Gioiee3/Extensometer-LoRa/README.md

# Extensometer with LoRa E32-400M30S
geological crack monitoring and landslide warning device using LoRa with esp32 and stm32
