Gioiee3/Extensometer-LoRa/Hardware/Extensometer/Project Outputs for Extensometer/Extensometer.xls

Comment | Description | Designator | Footprint | LibRef | Quantity
S4 | Dán | 1, 2, 4 | DIO-214AC(SMA) | Diode S4 | 3
47 uH | Inductor | 3, 0630 | inductor-7mm | Inductor | 2
Test Point | CONNECT 1 | 5V_off, 7V6, Solar, TP5 | TP_SMD | TP | 4
JP2 | WR-PHD 2.54 mm Angled Socket Header | BAT1S, BAT 1S, Light | JP2-C1T | JP2 | 3
100nF | Capacitor | C1, C3, C4, C6, C8, C10, C11, C12, C13, C14, C16, C18, C19, C21, C23, C24, C26, C28 | CAP_0805 | CapSMD | 18
10uF | Capacitor | C2, C5, C20, C22, C25, C29, C30 | CAP_0805 | CapSMD | 7
100uf/50V | Polarized Capacitor (Axial) | C7, C15 | CAP-ALU-SMD-8.3 | Cap Pol | 2
220uF/35V | Polarized Capacitor (Axial) | C9, C17 | CAP-ALU-SMD-8.3 | Cap Pol | 2
100nF | Capacitor | C27 | CAP_0402 | CapSMD | 1
SS54 | SS34 | D1, D2 | DIO-214AC(SMA) | Diode Zener | 2
SW | Switch button 2 pin | D35, VN, VP | SW2 | SW2 | 3
MAX485 | RS232 - RS485 (Same sn75176) | IC1 | SO-8 | MAX485 | 1
Connector 4x2 | Connector 4x2 | J1 | JP4x2 | JP4x2 | 1
Connector 3x2 | Connector 3x2 | J2 | JP3x2 | JP3x2 | 1
BAT | Jac DC input | JDC1 | DC-IN | DCIN | 1
BATTERY | Jac DC input | JDC2 | DC-IN | DCIN | 1
Adapter | Jac DC input | JDC3 | DC-IN | DCIN | 1
JP4 | WR-PHD 2.54 mm Angled Socket Header | LCD, SIM | JP4-C1T | JP4 | 2
LED | LED Single colour Green and Red | LED, LED2, LED3 | LED-0805-Blue | LED | 3
JP2 | WR-PHD 2.54 mm Angled Socket Header | MPPT | KF-128_2P_3.81 | JP2 | 2
2SC1815 | NPN 600mW, ECB | Q1, Q2, Q5, Q7 | SOT23D | C1815 | 4
AO3401 | 30V 5.8A P-Channel MOSFET | Q3, Q4, Q6, Q8 | SOT23A | MOSFET_P | 4
RU20P7C | 30V 5.8A P-Channel MOSFET | Q9, Q10 | SOT23A | MOSFET_P | 2
100k | Resistor SMD, Resistor | R1, R2, R5, R6, R19, R22, R32, R35, R36 | RES-SMD-0805 | Resistor - SMD | 9
1k | Resistor SMD, Resistor | R3, R4, R17, R20, R21, R34, R37 | RES-SMD-0805 | Resistor - SMD | 7
10k | Resistor | R7, R8, R9, R28, R29, R33 | RES-SMD-0805 | Resistor - SMD | 6
680R | Resistor | R10, R12 | RES-SMD-0805 | Resistor - SMD | 2
120 | Resistor | R11 | RES-SMD-0805 | Resistor - SMD | 1
10k | Resistor SMD | R13, R14, R23, R24, R25 | RES_SMD_0805 | Resistor - SMD | 5
39k | Resistor | R15, R27 | RES-SMD-0805 | Resistor - SMD | 2
0R | Resistor | R16, R26 | RES-SMD-0805 | Resistor - SMD | 2
11k | Resistor | R18 | RES-SMD-0805 | Resistor - SMD | 1
14k | Resistor | R30 | RES-SMD-0805 | Resistor - SMD | 1
3k9 | Resistor | R31 | RES-SMD-0805 | Resistor - SMD | 1
JP5 | WR-PHD 2.54 mm Angled Socket Header | Sensor | KF5-5 | JP5x1 | 1
A5 | Switch button 2 pin | SW1 | SW2 | SW2 | 1
A7 | Switch button 2 pin | SW2 | SW2 | SW2 | 1
SK12D07VG4 | Switch Slide ON ON SPDT Side Slide 0.3A 30VDC PC Pins Bracket Mount/Through Hole Bulk | Switch1 | SS12D01 | SK12D07VG4 | 1
SK12D07VG4 | Switch Slide ON ON SPDT Side Slide 0.3A 30VDC PC Pins Bracket Mount/Through Hole Bulk | Switch2 | SK12D07VG4 | SK12D07VG4 | 1
E32-400M30S |  | SX1, SX1278 | E32-400M30S | E32-400M30S | 2
JP8 PIN | JP8 PIN | TFT | JP8 | JP8 | 1
ESP32-DEVKIT-V1 | Dual core, Wi-Fi: 2.4 GHz up to 150 Mbits/s,BLE (Bluetooth Low Energy) and legacy Bluetooth, 32 bits, Up to 240 MHz | U1 | MODULE_ESP32_DEVKIT_V1 | ESP32-DEVKIT-V1 | 1
STM32 BluePill | STM32F103C8T6 breakout board | U2 | STM32 Bluepill | STM32 BluePill | 1
LM2976 |  | U3, U4 | TO-263 | LM2596 | 2
Ra-02 LoRa | LoRa Module Ra-02 | U5, U6 | Ra-02 | Ra-02 LoRa | 2
