Gioiee3/Extensometer-LoRa/Hardware/Extensometer/Project Outputs for Extensometer/List.xlsx

Comment | Description | Designator | Footprint | LibRef | Quantity
S4 | Dán | 1, 2, 4 | DIO-214AC(SMA) | Diode S4 | 3 | x
47 uH | Inductor | 3, 0630 | inductor-7mm | Inductor | 2 | x | CXT.VN – Từ ý tưởng đến sản phẩm - Cuộn cảm 47uH 0630 7x7x3mm (https://linhkien.cxt.vn/10533-cuon-cam-0630-cac-gia-tri.html)
10uF | Capacitor | C2, C5, C20, C22, C25, C29, C30 | CAP_0805 | CapSMD | 7 | x
100uf/50V | Polarized Capacitor (Axial) | C7, C15 | CAP-ALU-SMD-8.3 | Cap Pol | 2 | x | https://linhkien.cxt.vn/3033-tu-nhom-100uf-50v-8x105.html
220uF/35V | Polarized Capacitor (Axial) | C9, C17 | CAP-ALU-SMD-8.3 | Cap Pol | 2 | x | CXT.VN – Từ ý tưởng đến sản phẩm - Tụ nhôm 220uF 35V 8x10 mm (https://linhkien.cxt.vn/9690-tu-nhom-220uf-35v-8x10-mm.html)
SS54 | SS34 | D1, D2 | DIO-214AC(SMA) | Diode Zener | 2 | x
MAX485 | RS232 - RS485 (Same sn75176) | IC1 | SO-8 | MAX485 | 1 | x
BAT | Jac DC input | JDC1 | DC-IN | DCIN | 5 | x | CXT.VN – Từ ý tưởng đến sản phẩm - Jack nguồn DC-005 DC5521 cái 5.5x2.1mm - Chân cong (https://linhkien.cxt.vn/1331-jack-nguon-dc-005-dc5521-cai-55x21mm-chan-cong.html)
JP4 | WR-PHD 2.54 mm Angled Socket Header | LCD, SIM | JP4-C1T | JP4 | 2 | x |  | CXT.VN – Từ ý tưởng đến sản phẩm - Jack nguồn DC đực 12V 8A dài 30cm 2.5x2.1mm - Lõi đồng dày 0.75mm2 (https://linhkien.cxt.vn/10286-jack-nguon-dc-duc-12v-8a-dai-30cm-25x21mm-loi-dong-day-075mm2.html)
JP2 | WR-PHD 2.54 mm Angled Socket Header | MPPT | KF-128_2P_3.81 | JP2 | 2 | x | CXT.VN – Từ ý tưởng đến sản phẩm - Cầu đấu 2P KF128-2P 3.81mm Chân thẳng (https://linhkien.cxt.vn/9147-cau-dau-kf128-381mm-chan-thang.html)
AO3401 | 30V 5.8A P-Channel MOSFET | Q3, Q4, Q6, Q8 | SOT23A | MOSFET_P | 4 | x | CXT.VN – Từ ý tưởng đến sản phẩm - AO3401A P-Mosfet 30V 4A SOT-23-3 (https://linhkien.cxt.vn/1469-ao3401a-p-mosfet-30v-4a-sot-23-3.html)
RU20P7C | 30V 5.8A P-Channel MOSFET | Q9, Q10 | SOT23A | MOSFET_P | 2 | x | CXT.VN – Từ ý tưởng đến sản phẩm - RU20P7C Mosfet P-CH 5A 20V SOT-23 (https://linhkien.cxt.vn/3834-ru20p7c-mosfet-p-ch-5a-20v-sot-23.html)
100k | Resistor SMD, Resistor | R1, R2, R5, R6, R19, R22, R32, R35, R36 | RES-SMD-0805 | Resistor - SMD | 9 | x | ?
1k | Resistor SMD, Resistor | R3, R4, R17, R20, R21, R34, R37 | RES-SMD-0805 | Resistor - SMD | 7 | x
680R | Resistor | R10, R12 | RES-SMD-0805 | Resistor - SMD | 2 | x
120 | Resistor | R11 | RES-SMD-0805 | Resistor - SMD | 1 | x
10k | Resistor SMD | R13, R14, R23, R24, R25 | RES_SMD_0805 | Resistor - SMD | 5 | x
39k | Resistor | R15, R27 | RES-SMD-0805 | Resistor - SMD | 2 | x
0R | Resistor | R16, R26 | RES-SMD-0805 | Resistor - SMD | 2 | x
100k = 11k | Resistor | R18 | RES-SMD-0805 | Resistor - SMD | 1 | x | ?
14k | Resistor | R30 | RES-SMD-0805 | Resistor - SMD | 1 |  | ?
3k9 | Resistor | R31 | RES-SMD-0805 | Resistor - SMD | 1 | x
JP5 | WR-PHD 2.54 mm Angled Socket Header | Sensor | KF5-5 | JP5x1 | 1 | x | CXT.VN – Từ ý tưởng đến sản phẩm - Cầu đấu 2P KF128-2P 5.08mm Chân thẳng (https://linhkien.cxt.vn/1762-cau-dau-kf128-508mm-thang-nhat.html)
SK12D07VG4 | Switch Slide ON ON SPDT Side Slide 0.3A 30VDC PC Pins Bracket Mount/Through Hole Bulk | Switch1 | SS12D01 | SK12D07VG4 | 1 | x | CXT.VN – Từ ý tưởng đến sản phẩm - SS12D02 Công tắc gạt 3P 2.0mm (https://linhkien.cxt.vn/2719-ss12d02-cong-tac-gat-3p-20mm.html)
LM2976 |  | U3, U4 | TO-263 | LM2596 | 2 | x | CXT.VN – Từ ý tưởng đến sản phẩm - LM2596HVS-5.0 IC Reg Buck 5V 3A TO263-5 (https://linhkien.cxt.vn/2993-lm2596hvs-50-ic-reg-buck-5v-3a-to263-5.html)
 |  |  |  |  |  | x | CXT.VN – Từ ý tưởng đến sản phẩm - LM2596S-5.0 IC Reg Buck 5V 3A TO263-5 (https://linhkien.cxt.vn/1283-lm2596s-50-ic-reg-buck-5v-3a-to263-5.html)
 |  |  |  |  |  | x | CXT.VN – Từ ý tưởng đến sản phẩm - KCD1-101 Công tắc bập bênh 6A 250V 19x12mm - Đỏ (https://linhkien.cxt.vn/6076-kcd1-101-cong-tac-bap-benh-6a-250v-19x12mm.html)
 |  |  |  |  |  | x | CXT.VN – Từ ý tưởng đến sản phẩm - Cọc đồng M3 15mm cái-cái M3x15 (https://linhkien.cxt.vn/7478-coc-dong-m3-cai-cai.html)
 |  |  |  |  |  | x | CXT.VN – Từ ý tưởng đến sản phẩm - Ốc Vít M3x5mm (https://linhkien.cxt.vn/9132-oc-vit-m3x5mm.html)
 |  |  |  |  |  | x | CXT.VN – Từ ý tưởng đến sản phẩm - Dây XH2.54-4P 2.54mm 4P 2 Đầu - Dài 20cm (https://linhkien.cxt.vn/5981-day-xh254-2-dau-dai-20cm.html)
 |  |  |  |  |  |  | CXT.VN – Từ ý tưởng đến sản phẩm - Dây 2.54mm 2P XH2.54-2P 2 Đầu - Dài 20cm (https://linhkien.cxt.vn/6943-day-bus-xh254-254mm-2-dau-dai-20cm.html)
 |  |  |  |  |  |  | CXT.VN – Từ ý tưởng đến sản phẩm - Header Cái XH2.54-4P 2.54mm trắng (10c) (https://linhkien.cxt.vn/10180-header-cai-xh254-4p-254mm-trang-10c.html)
