Gioiee3/Extensometer-LoRa/(list of files, drawings)

Other design files:
Hardware/Extensometer/Extensometer.PrjPcb
Hardware/Extensometer/Hard_Node.SchDoc
