Gioiee3/Extensometer-LoRa/Firmware/Node/Extenso_SX1278_Final_No_Response/Core/Src/main.c

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
/* Includes ------------------------------------------------------------------*/
#include "main.h"
#include "adc.h"
#include "dma.h"
#include "i2c.h"
#include "rtc.h"
#include "spi.h"
#include "usart.h"
#include "gpio.h"

/* USER CODE BEGIN Includes */
#include "stdio.h"
#include "stdbool.h"
#include "stdlib.h"
#include "common.h"
#include "sx1278.h"
#include "string.h"
#include "modbus_crc.h"
#include "flash.h"
#include "aht20.h"

/* USER CODE END Includes */

/* USER CODE BEGIN PTD */
int __io_putchar (int ch)
{
   HAL_UART_Transmit(&huart2, (uint8_t *)&ch, 1, 100);
   return ch;
}

typedef struct LoRa_Link_Struct
{
  uint16_t Node_ID;
  uint16_t Node_Status;
  uint16_t Node_Battery_Voltage;
  uint16_t Node_Period;
} Link_Struct_t;
//modify
typedef struct LoRa_Data_Struct
{
  Link_Struct_t Link;
  uint16_t Node_LM35_Temperature;
  uint16_t Node_Range_Extenso;
  // uint16_t Node_AHT_Temperature;
  // uint16_t Node_AHT_Humidity;
  // uint16_t Node_wind_speed;
  // uint16_t Node_wind_direction;
  // uint16_t Node_wind_level;
} Data_Struct_t;

typedef struct LoRa_Packet_ID_0
{
  uint16_t Packet_ID;
  Link_Struct_t Payload;
} Link_Packet_t;

typedef struct LoRa_Packet_ID_1
{
  uint16_t Packet_ID;
  Data_Struct_t Payload;
} Data_Packet_t;

typedef struct LoRa_Packet_ID_2
{
  uint16_t Packet_ID;
  uint16_t Target_Node_ID;

  uint16_t Target_Node_Status;
  uint16_t Target_Node_Period;
  uint16_t Target_Node_Response;
} ResponsePacket_t;

// typedef struct WindData
// {
//   uint16_t rawTemperature;
//   float Temperature;

//   uint16_t RawSpeed;
// 	float Speed;
//   uint16_t Direction;
	
//   uint16_t windLevel;
// } WindData_t;
// add
typedef struct ExtensoData
{
  uint16_t rawTemperature;
  float Temperature;

  float range;
} ExtensoData_t;

typedef struct AHT20
{
  float Temperature;
  float Humidity;
} AHT20_t;

typedef enum NodeStatus
{
  WAKEUP_MODE = 1U,
  LINK_MODE = 2U,
  NORMAL_MODE = 4U,
  RECONNECT_MODE = 8U,
  SHUTDOWN_MODE = 16U
} NodeStatus_t;

/* USER CODE END PTD */

/* USER CODE BEGIN PD */

// #define NODE_ID     (0xCAAEU)
// #define NODE_ID     (0xCAADU)
// #define NODE_ID     (0xCAACU)
#define NODE_ID     (0xCAABU)

#define TIMEOUT_MS                  (50U)
#define LINK_PACKET_ID              (0xBBBBU)
#define DATA_PACKET_ID              (0x4A4AU)
#define RESPONSE_PACKET_ID          (0x4444U)

#define SLEEPTIME_NORMAL_MODE_MIN   (2U)
#define SLEEPTIME_NORMAL_MODE_SEC   (300U)
#define SLEEPTIME_LINK_MODE_MIN     (1U)
#define SLEEPTIME_RETRY_MODE_SEC    (10U)

#define READ_SENSORS_DURATION_MS    (4500U)

#define WAIT_RESPONSE_DURATION_MS   (2000U)

#define NODE_WAKEUP_BIT_SHIFT       (0U)
#define NODE_WAKEUP_BIT             (1U << NODE_WAKEUP_BIT_SHIFT)
#define NODE_LINK_MODE_BIT_SHIFT    (1U)
#define NODE_LINK_MODE_BIT          (1U << NODE_LINK_MODE_BIT_SHIFT)
#define NODE_NORMAL_MODE_BIT_SHIFT  (2U)
#define NODE_NORMAL_MODE_BIT        (1U << NODE_NORMAL_MODE_BIT_SHIFT)
#define NODE_RETRY_MODE_BIT_SHIFT   (3U)
#define NODE_RETRY_MODE_BIT         (1U << NODE_RETRY_MODE_BIT_SHIFT)

#define NODE_SHUTDOWN_MODE_BIT_SHIFT   (4U)
#define NODE_SHUTDOWN_MODE_BIT         (1U << NODE_RETRY_MODE_BIT_SHIFT)

#define LINK_ACCEPT   (0xAAU)
#define LINK_REJECT   (0x55U)

#define LINK_CARRYON  (0x00U)
#define LINK_DISMISS  (0xFFU)

#define LINK_ACK      (0xABU)
#define LINK_NACK     (0xBAU)

#define AHT10_ADDRESS_1 (0x38 << 1) // 0b1110000; Adress[7-bit]Wite/Read[1-bit]
#define AHT10_ADDRESS_2 (0x39 << 1) // 0b1110000; Adress[7-bit]Wite/Read[1-bit]

#define SAVE_ADDR     (0x08013030U)

#define SPEED_ADDRESS 		0x01
#define DIRECTION_ADDRESS 0x02

#define RESOLUTION_BRT 4096
#define CHU_VI_BRT	   100
/* USER CODE END PD */


void SystemClock_Config(void);
/* USER CODE BEGIN PFP */

void read_ADC(void);
void read_sensor_extenso();
void read_AHT20(void);

void going_standby(void);

void Link_Mode_Handle(void);
void Normal_Mode_Handle(void);
void Reconnect_Mode_Handle(void);

void Response_Handle(void);
/* USER CODE END PFP */

/* USER CODE BEGIN 0 */
uint16_t test_bat;
double test_bat_f, test_lm;
uint16_t adc[2];

static ExtensoData_t myExtenso;
static AHT20_t myAHT;

static NodeStatus_t myStatus;
static uint32_t backupStorage = 0U;
static uint8_t payload[100] = {0};
static volatile bool is_LoRa_EXTI = false;
static volatile bool is_All_Power_OFF = true;
static uint8_t array2store[32] = {0};
static volatile uint8_t nTry = 0;

uint8_t tx[50];
uint8_t uart1_tx_data[8];
uint8_t uart1_tx_set_add[8];
uint8_t uart1_tx_set_data[8];
uint8_t uart1_rx_data[15];
uint16_t recv_data[2];
uint32_t encod = 0;
float range_milimeter = 0;
uint8_t a[20];
uint32_t leng = 0, leng1 = 0;

uint16_t test_speed, test_level, test_di, test_dih;
float test_s;

uint8_t hum1, hum2, tempC1, tempC2, SUM, CHECK;
uint32_t pMillis, cMillis;
float temp_Celsius = 0;
float temp_Fahrenheit = 0;
float humidity = 0;
uint8_t hum_integral, hum_decimal, tempC_integral, tempC_decimal, tempF_integral, tempF_decimal;
char string[15];
uint8_t ver1;
float t, h;

void modbus_tx_data(uint8_t address)
{
	uart1_tx_data[0] = address; // slave address
	uart1_tx_data[1] = 0x03; // Function code for Read Input Registers (0x03)
	
	// where we want to start reading
	// The Register address will be 00000000 00000000 (40001)
	uart1_tx_data[2] = 0x00; 
	uart1_tx_data[3] = 0x00;
	
	// this 2 byte indicate how many 16-bit register we want to read.
	// we will read 2, 16-bit data register from_
	// 00000000 00000000 to 00000000 00000001 (from 40001 to 40002 according to salve datasheet)
	uart1_tx_data[4] = 0x00;
	uart1_tx_data[5] = 0x02; //Sensor wind speed is 0x01, direction is 0x02

	// CRC Check function
	uint16_t crc = crc16(uart1_tx_data, 6);
	uart1_tx_data[6] = crc & 0xFF; //CRC LOW
	uart1_tx_data[7] = (crc >> 8) & 0xFF; //CRC HIGH
	
	// set DE,RE pin HIGH to set max485 as transmitter mode
	HAL_GPIO_WritePin(GPIOA, GPIO_PIN_8, GPIO_PIN_SET);
	// sending the uart1_tx_data array
	HAL_UART_Transmit(&huart1, uart1_tx_data, 8, 1000);
	// set DE,RE pin LOW to set max485 as receiver mode
	HAL_GPIO_WritePin(GPIOA, GPIO_PIN_8, GPIO_PIN_RESET);
}

void modbus_tx_extenso(uint8_t address)
{
	uart1_tx_data[0] = address; // slave address
	uart1_tx_data[1] = 0x03; // Function code for Read Input Registers (0x03)

	// where we want to start reading
	// The Register address will be 00000000 00000000 (40001)
	uart1_tx_data[2] = 0x00;
	uart1_tx_data[3] = 0x00;

	// this 2 byte indicate how many 16-bit register we want to read.
	// we will read 2, 16-bit data register from_
	// 00000000 00000000 to 00000000 00000001 (from 40001 to 40002 according to salve datasheet)
	// so luong thanh ghi can doc
	uart1_tx_data[4] = 0x00;
	uart1_tx_data[5] = 0x02; //Sensor wind speed is 0x01, direction is 0x02

	// CRC Check function
	uint16_t crc = crc16(uart1_tx_data, 6);
	uart1_tx_data[6] = crc & 0xFF; //CRC LOW
	uart1_tx_data[7] = (crc >> 8) & 0xFF; //CRC HIGH

	// set DE,RE pin HIGH to set max485 as transmitter mode
	HAL_GPIO_WritePin(GPIOA, GPIO_PIN_8, GPIO_PIN_SET);
	// sending the uart1_tx_data array
	HAL_UART_Transmit(&huart1, uart1_tx_data, 8, 1000);
	// set DE,RE pin LOW to set max485 as receiver mode
	HAL_GPIO_WritePin(GPIOA, GPIO_PIN_8, GPIO_PIN_RESET);
}
/* USER CODE END 0 */

/**
  * @brief  The application entry point.
  * @retval int
  */
int main(void)
{

  /* MCU Configuration--------------------------------------------------------*/

  /* Reset of all peripherals, Initializes the Flash interface and the Systick. */
  HAL_Init();

  /* Configure the system clock */
  SystemClock_Config();

  /* Initialize all configured peripherals */
  MX_GPIO_Init();
  MX_DMA_Init();
  MX_SPI1_Init();
  MX_USART1_UART_Init();
  MX_ADC1_Init();
//  MX_I2C1_Init();
  MX_RTC_Init();
  MX_USART2_UART_Init();
//  MX_I2C2_Init();
  /* USER CODE BEGIN 2 */
  HAL_GPIO_WritePin(PWR_5V_GPIO_Port, PWR_5V_Pin, GPIO_PIN_SET);
  HAL_GPIO_WritePin(GPIOB, GPIO_PIN_0, 0);
  HAL_Delay(100);

//   sx1278_init();
  // HAL_Delay(50);

  myStatus = NORMAL_MODE;
 /*
  myStatus = HAL_RTCEx_BKUPRead(&hrtc, RTC_BKP_DR2);

  if (myStatus == 0U)
  {
    HAL_RTCEx_BKUPWrite(&hrtc, RTC_BKP_DR3, SLEEPTIME_NORMAL_MODE_MIN * 60);
    myStatus = NORMAL_MODE;
  }

  if ((myStatus & LINK_MODE) != 0U)
  {
    Link_Mode_Handle();
  }
  else if ((myStatus & NORMAL_MODE) != 0U)
      {
        Normal_Mode_Handle();
      }
      else if ((myStatus & RECONNECT_MODE) != 0U)
        {
          Normal_Mode_Handle();
//          Reconnect_Mode_Handle();
        }
*/
  Normal_Mode_Handle();
//  while (HAL_RTCEx_BKUPRead(&hrtc, RTC_BKP_DR2) != myStatus)  HAL_RTCEx_BKUPWrite(&hrtc, RTC_BKP_DR2, myStatus);

  HAL_GPIO_WritePin(PWR_5V_GPIO_Port, PWR_5V_Pin, GPIO_PIN_RESET);
  HAL_GPIO_WritePin(GPIOB, GPIO_PIN_0, 1);

//	HAL_GPIO_TogglePin(GPIOC, GPIO_PIN_13);
//	HAL_Delay(200);
//	HAL_GPIO_TogglePin(GPIOC, GPIO_PIN_13);

  going_standby();
  /* USER CODE END 2 */

  /* Infinite loop */
  /* USER CODE BEGIN WHILE */
  while (1)
  {
    /* USER CODE END WHILE */

    /* USER CODE BEGIN 3 */
//	  HAL_GPIO_WritePin(PWR_5V_GPIO_Port, PWR_5V_Pin, GPIO_PIN_SET);
	  HAL_Delay(100);
//	  HAL_GPIO_WritePin(GPIOB, GPIO_PIN_12, GPIO_PIN_SET);
//	  HAL_Delay(8000);
//	  modbus_tx_extenso(0x01);
//read_sensor_extenso();
//	  read_ADC();
//HAL_GPIO_WritePin(PWR_5V_GPIO_Port, PWR_5V_Pin, GPIO_PIN_RESET);
//	  HAL_GPIO_WritePin(GPIOB, GPIO_PIN_12, GPIO_PIN_SET);
//	  HAL_GPIO_WritePin(GPIOB, GPIO_PIN_0, 0);
//	  HAL_Delay(440);			// time delay for sensor init
//	  modbus_tx_extenso(0x01);
//	  HAL_Delay(50);
//	  HAL_GPIO_WritePin(GPIOB, GPIO_PIN_0, 1);
//	  HAL_GPIO_WritePin(GPIOB, GPIO_PIN_12, GPIO_PIN_RESET);
	  HAL_Delay(900);

//			read_ADC();
		/*  MX_SPI1_Init();
			HAL_Delay(100);
			sx1278_init();
			sprintf((char*) tx, "BAT la %d", test_bat);
			sx1278_send_data(tx, sizeof(tx));
			HAL_SPI_DeInit(&hspi1);
*/

  }
  /* USER CODE END 3 */
}

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
/* USER CODE BEGIN 4 */

void HAL_UARTEx_RxEventCallback(UART_HandleTypeDef *huart, uint16_t Size)
{
	recv_data[0] = uart1_rx_data[3]<<8 | uart1_rx_data[4];
	recv_data[1] = uart1_rx_data[5]<<8 | uart1_rx_data[6];
	encod 	 	 = recv_data[0]<<16 | recv_data[1];
	HAL_UARTEx_ReceiveToIdle_IT(&huart1, uart1_rx_data, 15);
}

void read_ADC(void)
{
	HAL_ADC_Start_DMA(&hadc1,(uint32_t*) adc, 2);
	uint32_t bat = 0, temp35 = 0;
	HAL_Delay(20);
	for(uint8_t i = 0; i<100; i++)
	{
		bat += adc[0];
		temp35 += adc[1];
		HAL_Delay(1);
	}

	bat = bat/100;
	test_bat_f =(double)((double)bat * 3.3 * 4.0 / 4095.0) + 0.48;// - 0.22656;
		
    temp35 = temp35 / 100;
    myExtenso.rawTemperature = temp35;
    myExtenso.Temperature = (float)((float)temp35 * 3.3 /4095.0 + 2.5); // node 2: + 3.2
	  
    test_lm = (float) myExtenso.Temperature;
	HAL_ADC_Stop_DMA(&hadc1);
}

void read_sensor_extenso()
{
	MX_USART1_UART_Init();
	HAL_Delay(100);
	HAL_UARTEx_ReceiveToIdle_IT(&huart1, uart1_rx_data, 15);
	HAL_GPIO_WritePin(PWR_SEN_GPIO_Port, PWR_SEN_Pin, GPIO_PIN_SET);
//	HAL_GPIO_WritePin(GPIOC, GPIO_PIN_13, 1);
	HAL_Delay(450);			// time delay for sensor init
	modbus_tx_extenso(0x01);
	HAL_Delay(60);
//	range_milimeter = 0;
	if (encod > 98000) encod = 0;
	if (encod > 0) range_milimeter = (float)((float)encod * CHU_VI_BRT/RESOLUTION_BRT) - 58.8;
//	if (range_milimeter <= 0) range_milimeter = 0;
	myExtenso.range = range_milimeter;
//	HAL_GPIO_WritePin(GPIOC, GPIO_PIN_13, 0);
	HAL_GPIO_WritePin(PWR_SEN_GPIO_Port, PWR_SEN_Pin, GPIO_PIN_RESET);
	HAL_UART_DeInit(&huart1);
}

void going_standby(void)
{
  /* Enable WUPIN PA0: HAL_PWR_EnableWakeUpPin(PWR_WAKEUP_PIN1) */
  SET_BIT(PWR->CSR, PWR_CSR_EWUP);

  /* Set RTC Alarm for 300s */
  RTC_TimeTypeDef timeNow;
  RTC_AlarmTypeDef timeAlarm;
  HAL_RTC_GetTime(&hrtc, &timeNow, RTC_FORMAT_BCD);
  timeAlarm.Alarm = RTC_ALARM_A;
  timeAlarm.AlarmTime = timeNow; // luu thoi gian hien tai
  if (myStatus == NORMAL_MODE)
  {
//		timeAlarm.AlarmTime.Seconds += 2;
	  timeAlarm.AlarmTime.Minutes += SLEEPTIME_NORMAL_MODE_MIN; // + thoi gian cua chu ky
  }
  else if (myStatus == LINK_MODE)
      {
		timeAlarm.AlarmTime.Seconds += 3;
        //timeAlarm.AlarmTime.Minutes += SLEEPTIME_LINK_MODE_MIN;
      }
      else if (myStatus == RECONNECT_MODE)
          {
//			timeAlarm.AlarmTime.Seconds += 1;
            timeAlarm.AlarmTime.Seconds += SLEEPTIME_RETRY_MODE_SEC;
          }

  __HAL_RTC_ALARM_CLEAR_FLAG(&hrtc, RTC_FLAG_ALRAF);
  HAL_RTC_SetAlarm_IT(&hrtc, &timeAlarm, RTC_FORMAT_BCD); // enable interrupt

  //STANDBY mode
  /* Set SLEEPDEEP bit of Cortex System Control Register */
  SET_BIT(SCB->SCR, ((uint32_t)SCB_SCR_SLEEPDEEP_Msk));

  /* Select Standby mode */
  SET_BIT(PWR->CR, PWR_CR_PDDS);

  /* Clear WUF bit in Power Control/Status register */
  SET_BIT(PWR->CR, PWR_CR_CWUF); /*!< Clear Wakeup Flag */

  /* Clear SBF bit in Power Control/Status register */
  SET_BIT(PWR->CR, PWR_CR_CSBF); /*!< Clear Standby Flag */

  (void)PWR->CR;
  (void)PWR->CSR;

  // Disable debug, trace and IWDG in low-power modes
  DBGMCU->CR = (uint32_t)0x00;

// #if DEBUG == 1
//   logPC("Bravo 6\nGoing Dark\n");
// #endif /* DEBUG == 1 */

  for (;;)
  {
    __DSB();
    __WFI(); // Wait for interrupt
  }
}
//kiem tra xem truyen thong duoc khong
bool is_OK_2_Talk(void)
{
  sx1278_standby();
  uint32_t checkTimeout = HAL_GetTick();
  uint8_t irq = sx1278_read_reg(REG_IRQ_FLAGS);
  sx1278_write_reg(REG_IRQ_FLAGS, irq);     //reset irq
  is_LoRa_EXTI = false;
  sx1278_cad();
  while ((is_LoRa_EXTI == false) && ((HAL_GetTick() - checkTimeout) < TIMEOUT_MS));
  if (is_LoRa_EXTI == false) return false;
  irq = sx1278_read_reg(REG_IRQ_FLAGS);
  sx1278_write_reg(REG_IRQ_FLAGS, irq);     //reset irq
  sx1278_standby();
  if (((irq & 0x01U) != 0U) && ((irq & 0x04U) != 0U))
  {
    return false;
  }
  else if (((irq & 0x01U) == 0U) && ((irq & 0x04U) != 0U))
      {
        return true;
      }
  return false;
}

void Link_Mode_Handle(void)
{
  read_ADC();
  HAL_Delay(5);
  
  MX_SPI1_Init();
  HAL_Delay(100);
  sx1278_init();

  Link_Packet_t LinkReq;
  LinkReq.Packet_ID = LINK_PACKET_ID;
  LinkReq.Payload.Node_ID = NODE_ID;
  LinkReq.Payload.Node_Status = myStatus;
  LinkReq.Payload.Node_Battery_Voltage = (uint16_t)(test_bat_f * 100.0); // 100 x Bat_voltage
  LinkReq.Payload.Node_Period = (uint16_t) (HAL_RTCEx_BKUPRead(&hrtc, RTC_BKP_DR3));
  memcpy((uint8_t*)&payload, (uint8_t*)&LinkReq, sizeof(Link_Packet_t));

  nTry = 0;
  while ((is_OK_2_Talk() == false) && (nTry < 10))
  {
    nTry++;
    HAL_Delay(110);
    // HAL_Delay(get_random_value(backupStorage, 50, 200));
  }
  
  if (nTry == 10)
  {
    myStatus = LINK_MODE;
    HAL_SPI_DeInit(&hspi1);
    return;
  }

  sx1278_send_data((uint8_t *)&payload, sizeof(Link_Packet_t));

  Response_Handle();

  sx1278_sleep();
  HAL_SPI_DeInit(&hspi1);
}

void Normal_Mode_Handle(void)
{
  read_ADC();
  HAL_Delay(5);
  read_sensor_extenso();
  // read_AHT20();

  HAL_Delay(50);
  MX_SPI1_Init();
  HAL_Delay(100);
  sx1278_init();

  Data_Packet_t data_packet;
  data_packet.Packet_ID = DATA_PACKET_ID;
  data_packet.Payload.Link.Node_ID = NODE_ID;
  data_packet.Payload.Link.Node_Status = myStatus;
  data_packet.Payload.Link.Node_Battery_Voltage = (uint16_t)(test_bat_f * 100.0); // 100 x Bat_voltage
  data_packet.Payload.Link.Node_Period      = (uint16_t)(HAL_RTCEx_BKUPRead(&hrtc, RTC_BKP_DR3));

  data_packet.Payload.Node_LM35_Temperature = (uint16_t)(myExtenso.Temperature * 10); // 10 x temp_lm35
  data_packet.Payload.Node_Range_Extenso    = (uint16_t)(myExtenso.range * 10);                        // range of extenso
  // data_packet.Payload.Node_AHT_Temperature  = (uint16_t)(myAHT.Temperature * 10);  // 10 x temp_aht
  // data_packet.Payload.Node_AHT_Humidity     = (uint16_t)(myAHT.Humidity * 10);     // 10 x humid_aht
  // data_packet.Payload.Node_wind_speed       = (uint16_t)(myWind.Speed * 10);       // 10 x wind speed
  // data_packet.Payload.Node_wind_direction   = myWind.Direction;                    // direction type uint16
  // data_packet.Payload.Node_wind_level       = myWind.windLevel;                    // direction type uint16
  memset(payload, '\0', sizeof(payload));
  memcpy((uint8_t *)payload, (uint8_t *)&data_packet, sizeof(Data_Packet_t));
  
  nTry = 0;
  while ((is_OK_2_Talk() == false) && (nTry < 10))
  {
    nTry++;
    HAL_Delay(150);
    // HAL_Delay(get_random_value(backupStorage, 50, 200));
  }
//  if (nTry == 10)
//  {
//    myStatus = RECONNECT_MODE;
//    HAL_SPI_DeInit(&hspi1);
//    // HAL_GPIO_WritePin(PWR_SUB_GPIO_Port, PWR_SUB_Pin, GPIO_PIN_RESET);
//    // HAL_GPIO_WritePin(LED0_GPIO_Port, LED0_Pin, GPIO_PIN_SET);
//    return;
//  }

  sx1278_send_data(payload, sizeof(Data_Packet_t));
//  Response_Handle();

//  if (myStatus == RECONNECT_MODE)
//  {
//    memset(array2store, '\0', sizeof(array2store));
//    memcpy((uint8_t *)&array2store, (uint8_t *)&data_packet, sizeof(Data_Packet_t)); // save value measured
//    Flash_Write_Data(SAVE_ADDR, (uint32_t*)&array2store, 8U);
//    HAL_Delay(300);
//  }

  sx1278_sleep();
  HAL_SPI_DeInit(&hspi1);
}

void Reconnect_Mode_Handle(void) 
{
  Flash_Read_Data(SAVE_ADDR, (uint32_t *)&array2store, sizeof(array2store));
  array2store[4] = RECONNECT_MODE;
  memcpy((uint8_t *)payload, (uint8_t *)&array2store, sizeof(Data_Packet_t));

  MX_SPI1_Init();
  HAL_Delay(100);
  sx1278_init();

  nTry = 0;
  while ((is_OK_2_Talk() == false) && (nTry < 10))
  {
    nTry++;
    HAL_Delay(110);
    // HAL_Delay(get_random_value(backupStorage, 50, 200));
  }
  if (nTry == 10)
  {
    myStatus = RECONNECT_MODE;
    HAL_SPI_DeInit(&hspi1);
    return;
  }

  sx1278_send_data(payload, sizeof(Data_Packet_t));

  Response_Handle();

  sx1278_sleep();
  HAL_SPI_DeInit(&hspi1);
}

void Response_Handle(void)
{
  static ResponsePacket_t resp;
  static uint8_t data[100] = {0};
  static uint32_t nByteRx = 0;
  static int rssi = -1;
  static float snr = -1;

  is_LoRa_EXTI = false;
  sx1278_start_recv_data();

  uint32_t timeOut = HAL_GetTick();
  while ((HAL_GetTick() - timeOut) < 5000U)
  {
    if (is_LoRa_EXTI == true)
    {
      if (sx1278_recv_data((uint8_t *)data, &nByteRx, &rssi, &snr, false) == SX1278_OK)
      {
        if (nByteRx == sizeof(ResponsePacket_t))  memcpy(&resp, &data, sizeof(ResponsePacket_t));
        else
        {
          is_LoRa_EXTI = false;
          sx1278_set_irq(0x00);
          sx1278_write_reg(REG_IRQ_FLAGS, sx1278_read_reg(REG_IRQ_FLAGS));
          continue;
        }
        
        if ((resp.Packet_ID != RESPONSE_PACKET_ID) || (resp.Target_Node_ID != NODE_ID))
        {
          // this is not what I want OR this is not for me
          is_LoRa_EXTI = false;
          sx1278_start_recv_data();
          continue;
        }
        else
        {
          // Yep ok this is my packet and ID
          if (myStatus == LINK_MODE)
          {
            if ((resp.Target_Node_Response & 0x00FF) != LINK_ACK) {myStatus = LINK_MODE; return;}
            if      (((resp.Target_Node_Response >> 8) & 0x00FF) == LINK_ACCEPT)    myStatus = NORMAL_MODE;
            else if (((resp.Target_Node_Response >> 8) & 0x00FF) == LINK_REJECT)    myStatus = (uint8_t)resp.Target_Node_Status;
          }
          else if (myStatus == NORMAL_MODE)
              {
                if ((resp.Target_Node_Response & 0x00FF) != LINK_ACK) {myStatus = RECONNECT_MODE; return;}
                if      (((resp.Target_Node_Response >> 8) & 0x00FF) == LINK_CARRYON)   myStatus = (uint8_t)resp.Target_Node_Status;
                else if (((resp.Target_Node_Response >> 8) & 0x00FF) == LINK_DISMISS)   myStatus = LINK_MODE;
              }
              else if (myStatus == RECONNECT_MODE)
              {
                if      ((resp.Target_Node_Response & 0x00FF) != LINK_ACK) {myStatus = RECONNECT_MODE;  return;}
                else if ((resp.Target_Node_Response & 0x00FF) == LINK_ACK) {myStatus = NORMAL_MODE;}
                if      (((resp.Target_Node_Response >> 8) & 0x00FF) == LINK_CARRYON)   myStatus = (uint8_t)resp.Target_Node_Status;
                else if (((resp.Target_Node_Response >> 8) & 0x00FF) == LINK_DISMISS)   myStatus = LINK_MODE;
              }
          HAL_RTCEx_BKUPWrite(&hrtc, RTC_BKP_DR3, resp.Target_Node_Period);
          return;
        }
      }
      else
      {
        is_LoRa_EXTI = false;
        sx1278_set_irq(0x00);
        sx1278_write_reg(REG_IRQ_FLAGS, sx1278_read_reg(REG_IRQ_FLAGS));
        continue;
      }
    }
  }
  
  if (myStatus == LINK_MODE)
  {
    myStatus = LINK_MODE;
  }
  else if (myStatus == NORMAL_MODE)
      {
        myStatus = RECONNECT_MODE;
      }
      else if (myStatus == RECONNECT_MODE)
          {
            myStatus = RECONNECT_MODE;
          }
}

void HAL_GPIO_EXTI_Callback(uint16_t GPIO_Pin)
{
  if ((GPIO_Pin == LoRa_EXT0_Pin) && (HAL_GPIO_ReadPin(LoRa_EXT0_GPIO_Port, LoRa_EXT0_Pin) == GPIO_PIN_SET) && (is_LoRa_EXTI == false))
  {
    is_LoRa_EXTI = true;
  }
}

void HAL_RTCEx_RTCEventCallback(RTC_HandleTypeDef *hrtc)
{
  HAL_NVIC_SystemReset();
}

/* USER CODE END 4 */
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
