Gioiee3/Extensometer-LoRa/Firmware/Node/Extenso_SX1278_Final_No_Response/Core/Inc/main.h

#define LED_Pin GPIO_PIN_0
#define LED_GPIO_Port GPIOB
#define LoRa_EXT0_Pin GPIO_PIN_1
#define LoRa_EXT0_GPIO_Port GPIOB
#define LoRa_EXT0_EXTI_IRQn EXTI1_IRQn
#define PWR_SEN_Pin GPIO_PIN_12
#define PWR_SEN_GPIO_Port GPIOB
#define PWR_5V_Pin GPIO_PIN_13
#define PWR_5V_GPIO_Port GPIOB
#define TXEN_Pin GPIO_PIN_14
#define TXEN_GPIO_Port GPIOB
#define RXEN_Pin GPIO_PIN_15
#define RXEN_GPIO_Port GPIOB
#define DE_Pin GPIO_PIN_8
#define DE_GPIO_Port GPIOA
#define SPI1_CS_Pin GPIO_PIN_15
#define SPI1_CS_GPIO_Port GPIOA
#define LoRa_RST_Pin GPIO_PIN_6
#define LoRa_RST_GPIO_Port GPIOB
