Gioiee3/Extensometer-LoRa/(notices)

Notices in the files:
Firmware/Node/Extenso_SX1278_Final_No_Response/Core/Src/main.c:
Copyright (c) 2024 STMicroelectronics.
All rights reserved.
This software is licensed under terms that can be found in the LICENSE file
